penguinyogurt/BME-261/channelAstudy/2026-07-23_134851.png

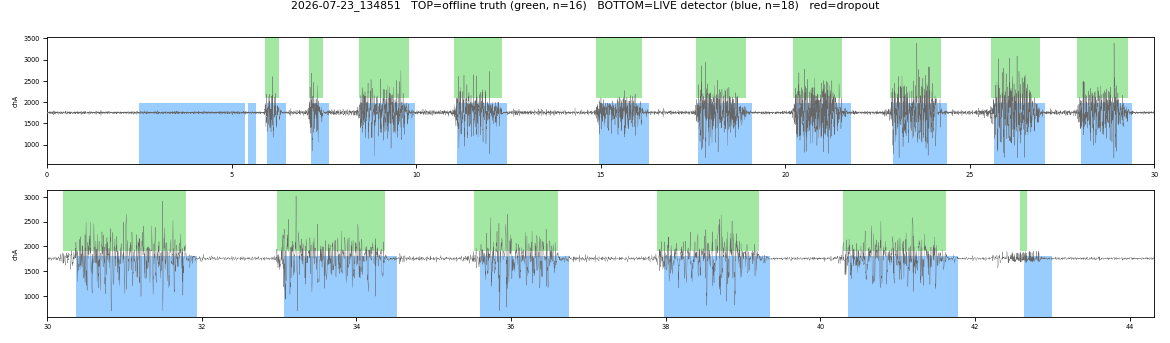
channelAstudy/2026-07-23_134851.png
