penguinyogurt/BME-261/channelAstudy/2026-07-23_182349.png

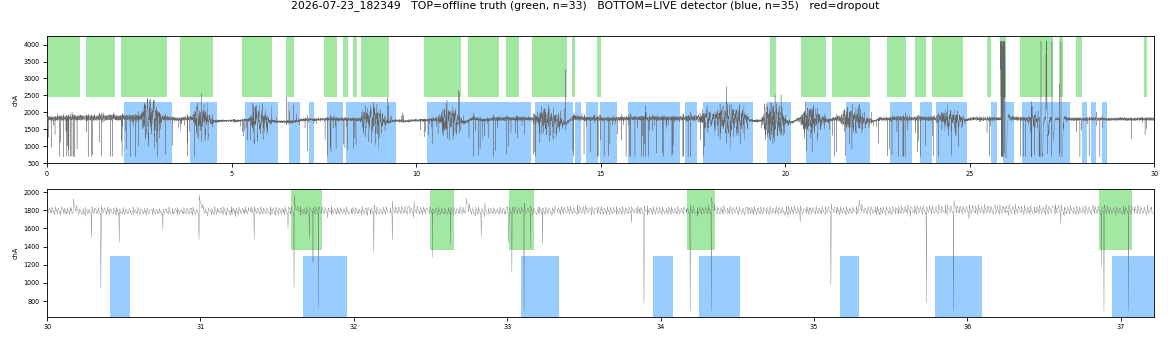
channelAstudy/2026-07-23_182349.png
