penguinyogurt/BME-261/channelAstudy/2026-07-23_190832.png

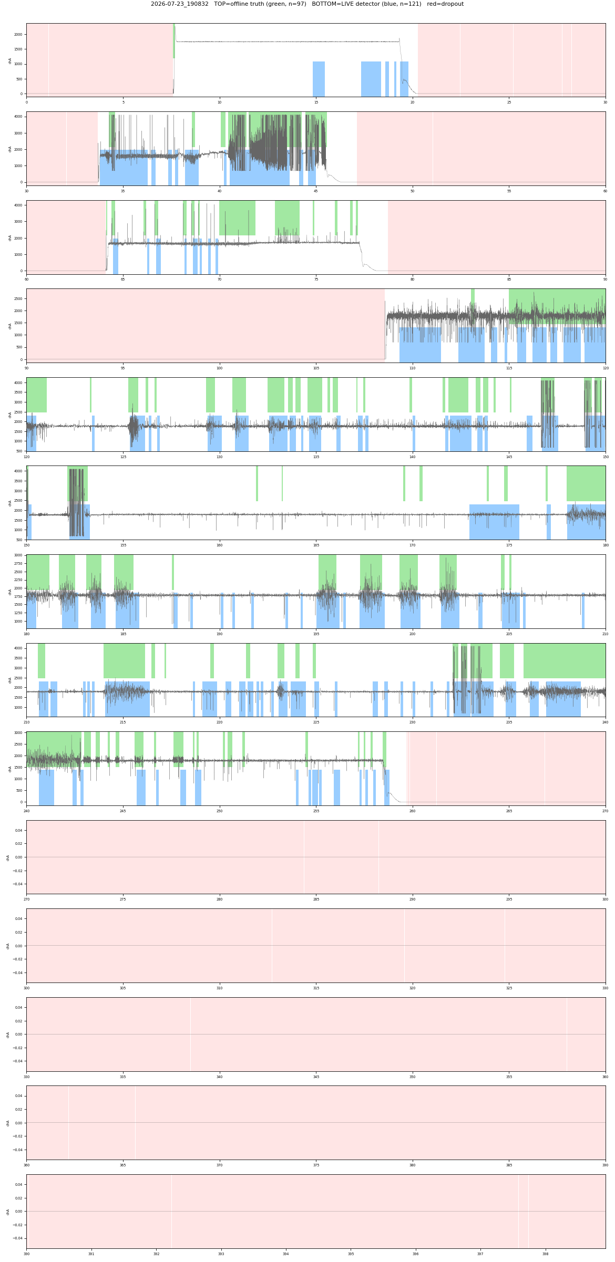
channelAstudy/2026-07-23_190832.png
