penguinyogurt/BME-261/channelAstudy/2026-07-23_195519.png

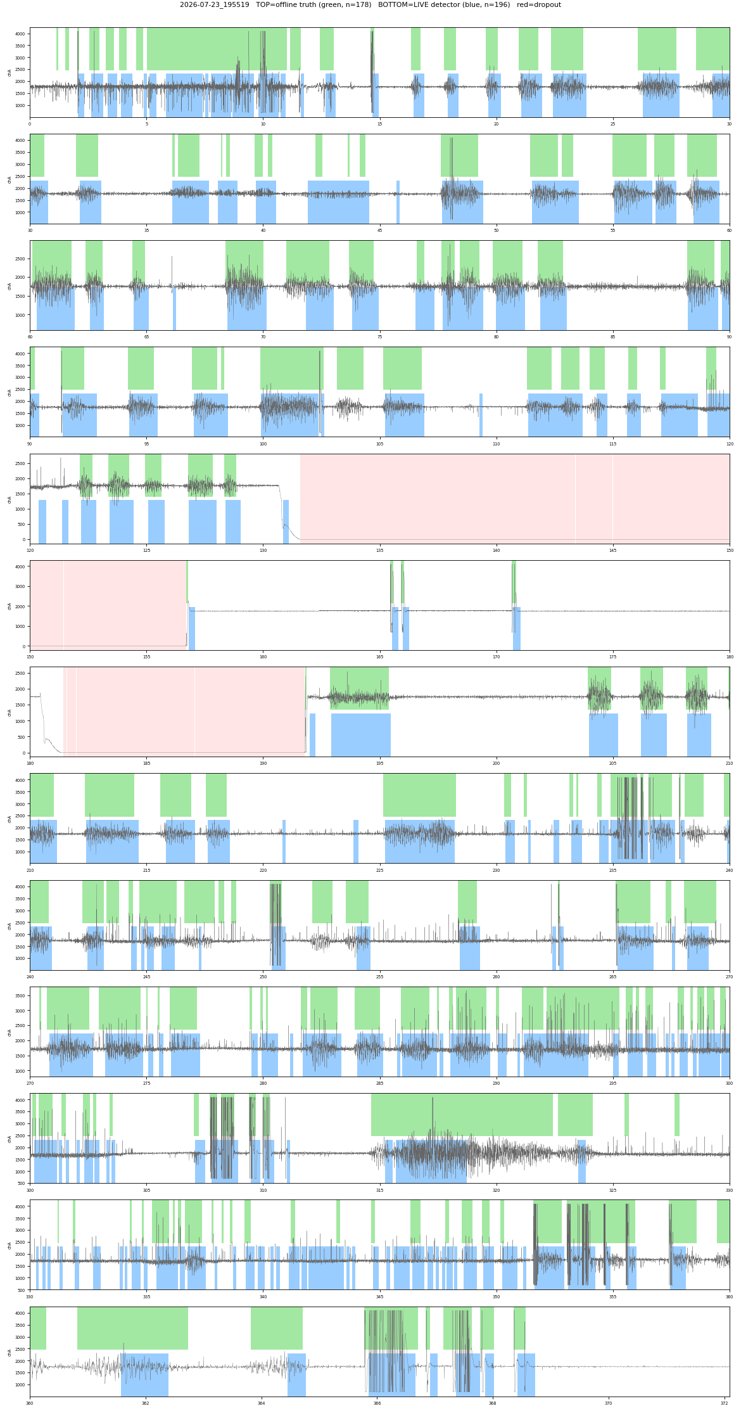
channelAstudy/2026-07-23_195519.png
