penguinyogurt/BME-261/channelAstudy/2026-07-23_202105.png

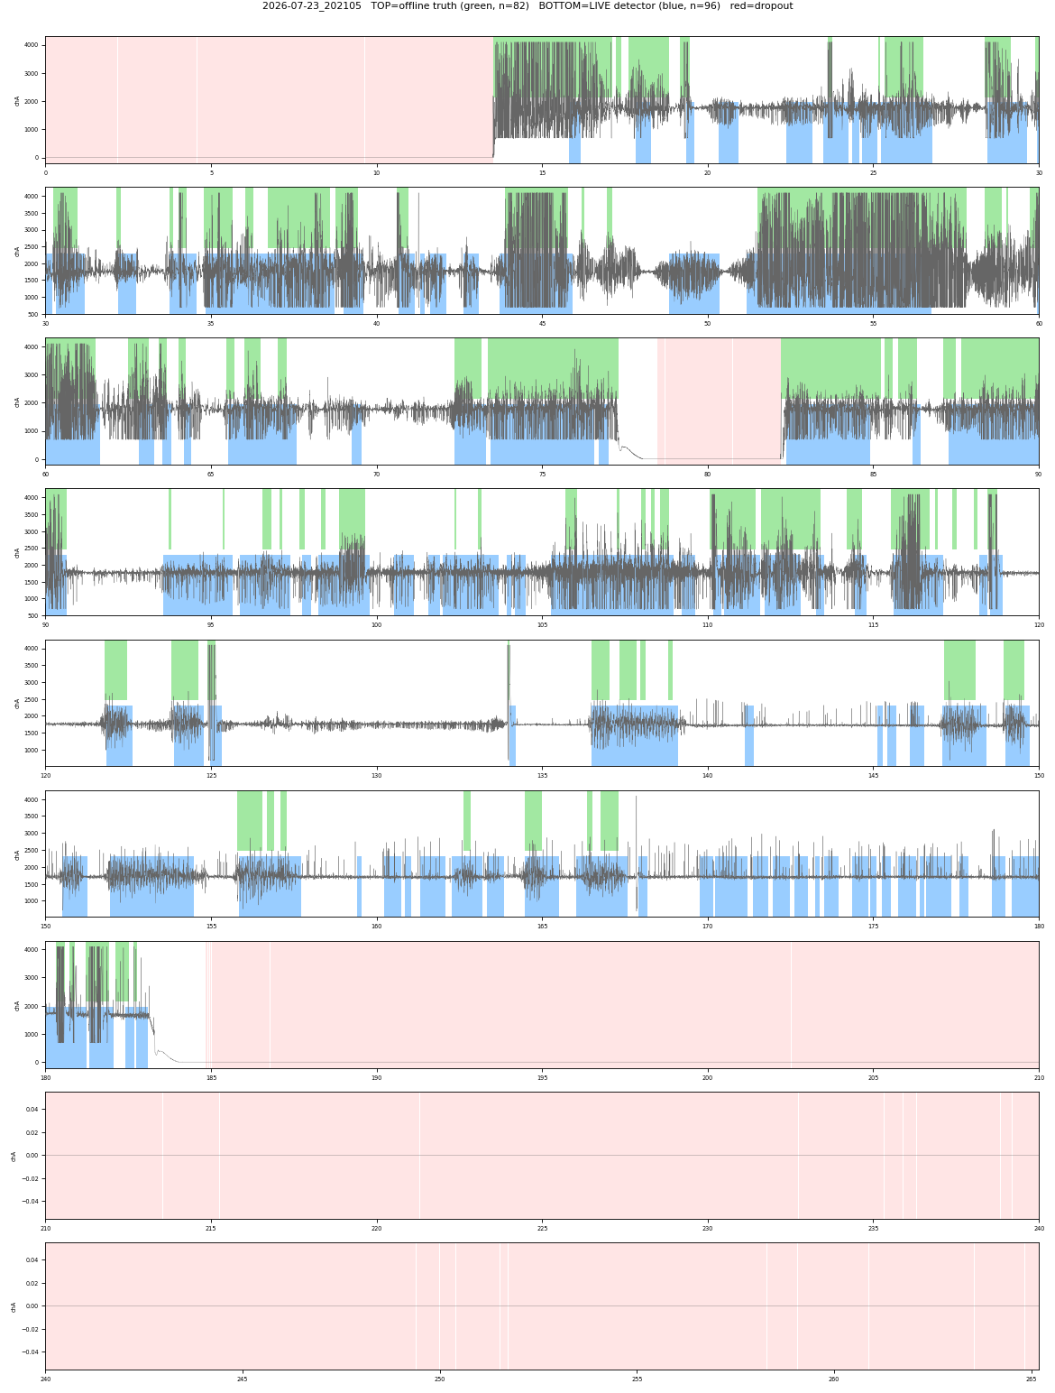
channelAstudy/2026-07-23_202105.png
