penguinyogurt/BME-261/channelAstudy/operating_points.csv

frac_hi | frac_lo | precision | recall | f1 | TP | FN | FP | median_latency_ms
0.06 | 0.03 | 0.6583 | 0.7632 | 0.7068 | 522 | 162 | 271 | 68.0
0.08 | 0.04 | 0.6871 | 0.7865 | 0.7335 | 538 | 146 | 245 | 70.0
0.1 | 0.05 | 0.7064 | 0.788 | 0.745 | 539 | 145 | 224 | 72.0
0.12 | 0.06 | 0.716 | 0.7851 | 0.749 | 537 | 147 | 213 | 72.0
0.14 | 0.07 | 0.7218 | 0.7661 | 0.7433 | 524 | 160 | 202 | 74.0
0.18 | 0.09 | 0.7233 | 0.7222 | 0.7228 | 494 | 190 | 189 | 78.0
0.22 | 0.11 | 0.7282 | 0.6974 | 0.7125 | 477 | 207 | 178 | 84.0
0.28 | 0.14 | 0.7284 | 0.6272 | 0.674 | 429 | 255 | 160 | 90.0
0.35 | 0.175 | 0.7559 | 0.5658 | 0.6472 | 387 | 297 | 125 | 104.0
