penguinyogurt/BME-261/(commit log)

2026-07-22 Add EMG firmware, viewer, servo drive/receiver code, and datasheets
    - BME EMG Arduino Collection.ino: ESP32 EMG sampling firmware with self-test
    - emg-csvs/: serial live-plot viewer plus two captured sample runs
    - hsr2645cr_drive/: working HSR-2645CR continuous-rotation servo demo
    - servo-receiver/: PlatformIO scaffold for the ESP-NOW servo board
    (prints its STA MAC 7C:87:CE:30:FA:88 for sender pairing)
    - ESP32-WROOM-32 and HSR-2645CR datasheets, .gitignore
    [emg_2026-07-21_140307.csv, emg_2026-07-21_140447.csv]
2026-07-23 Reorganize into firmware/tools/data/docs
    - firmware/: all sketches; the loose EMG sketch becomes
    firmware/emg-collector/emg-collector.ino so the folder matches the .ino
    basename (arduino-cli could not build it before)
    - tools/: Python viewer, serial monitor, and offline simulators
    - data/: logged captures + synthetic sets
    - docs/: datasheets
    - scripts now resolve data/ and output/ from the repo root
    - drop duplicate dual_monitor.py (superseded by tools/dual_serial_monitor.py)
    - gitignore generated plots (output/); README documents the layout
    [emg_2026-07-21_140307.csv, emg_2026-07-21_140447.csv, emg_2026-07-23_134728.csv, emg_2026-07-23_134851.csv, emg_synth_close_hold_open.csv, emg_synth_graded_ramp.csv, emg_synth_open_close.csv, emg_synth_rapid_open_close_reps.csv]
2026-07-23 Fix drift-induced perma-close with an adaptive envelope baseline
    The grip would latch closed and never release. Root cause was not the
    calibration trial but the baseline it is measured against: chB's DC was
    measured drifting ~400 counts in 12 s, far wider than T_high, so a one-shot
    tare turned drift into a permanent phantom contraction.
    - envUpdate() now tracks the baseline continuously instead of taring once,
    and handles the two channels as the different signals they are: chB is a
    unipolar envelope (baseline rides the resting floor, clamp at 0), chA is
    bipolar around mid-rail (baseline is the DC bias, rectify).
    - setSource()/calibrate() take the baseline over ~200-500 ms via meanOf()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
    [emg_2026-07-23_171239.csv, emg_2026-07-23_182349.csv, emg_2026-07-23_185723.csv, emg_2026-07-23_185816.csv, emg_2026-07-23_185937.csv]
2026-07-24 Add five more 7-23 capture runs
    Logged with the 4-field firmware, so these carry the env and intent columns
    the earlier runs lack. They cover the cases the older captures did not:
    - 195519, 190832, 202105 have heavy front-end brown-out (chB flat at 0 for
    long stretches)
    - 200828 catches the peak detector's power-on transient, where the firmware
    false-latched a full grip for ~50 s
    - 171239 has a resting floor that steps up ~450 counts mid-recording
    [emg_2026-07-23_193836.csv, emg_2026-07-23_200457.csv, emg_2026-07-23_200828.csv, emg_2026-07-23_202105.csv]
2026-07-24 Add offline replay harness for intent algorithms
    replay_intent.py auto-loads plugins from tools/algos/ and drives each one
    through a shared latching FSM, so competing methods stay apples-to-apples and
    several can be developed in parallel without fighting over one file.
    Causality is enforced structurally rather than by review: a plugin exposes a
    Detector whose update() is fed ONE SAMPLE AT A TIME in arrival order, so it
    cannot see the future even by accident. The three pre-existing algorithms
    (simple/adaptive/fixed) derive thresholds from whole-file percentiles, i.e.
    they peek; they are kept as the incumbent reference but relabelled non-causal.
    play_replay.py replays a logged trial at wall-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
    [play_replay.py, replay_intent.py, sim_simple.py, test_replay.py]
2026-07-24 Add offline answer key and a scorer for intent methods
    There is no recorded ground truth in this project — nobody logged "I squeezed
    now" — so make_answer_key.py builds a strong offline ESTIMATE and labels every
    tick ACTIVE / REST / EXCLUDED. It is deliberately acausal, which is exactly
    what makes it usable as a reference: zero-phase smoothing so onsets are not
    dragged late by filter lag, a CENTERED rest tracker, duration priors in both
    directions, and onset refinement that walks backward to where the raw signal
    actually left rest. No live detector may do any of that.
    Thresholds are scaled to each trial's own resting MAD, not chosen by Otsu:
    the pooled excess-over-rest distribution is o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
    [emg_2026-07-23_134728_key.csv, emg_2026-07-23_134851_key.csv, emg_2026-07-23_171239_key.csv, emg_2026-07-23_182349_key.csv, emg_2026-07-23_185723_key.csv, emg_2026-07-23_185816_key.csv, emg_2026-07-23_185937_key.csv, emg_2026-07-23_190832_key.csv]
2026-07-24 Add the channel-A detection study
    External study of intent detection from chA (raw bandpass) rather than chB:
    DC removal, 20-200 Hz bandpass, TKEO, envelope, hybrid sigma/amplitude
    threshold, Schmitt trigger. Reports leave-one-out F1 0.763 over 684 reference
    bursts, with its own acausal labeler and causality proofs.
    Kept in-tree because it contradicts a premise the rest of this work was built
    on. CLAUDE.md states chA is DEAD and rests near 500 counts; measured across
    every live trial it rests at 1721-1789 counts with std 180-596 and substantial
    high-frequency content. That is working raw EMG, and all seven detectors in
    tools/algos/ ignored it because the project notes said not to bother.
    T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
    [ground_truth_bursts.csv, operating_points.csv]
2026-07-24 Drive intent from the dual-rate ratio, and fix the open travel budget
    DETECTION. Replaces the tared-floor threshold with dualrate: activity is the
    ratio of a fast (40 ms) envelope to a slow one, so it is dimensionless. The
    thresholds become pure numbers and a drifting resting floor moves them with it,
    which removes the tare step entirely — there is nothing to hold still for and
    nothing to calibrate. Chosen by scoring seven causal methods against the
    offline answer key; it was the only one that improved from fit to test, and the
    brute-forced absolute thresholds it beat collapse to 51% quiet on held-out data
    because a fixed number ends up below the resting floor when that floor drifts.
    Veri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
    [emg-collector.ino]
2026-07-24 Add a browser jog control for the servo, over USB serial
    Browser -> local Python server -> USB serial -> the receiver's new "m<intent>"
    command. Serial rather than an on-board web server so the ESP-NOW link is not
    involved at all and cannot be destabilised by sharing a WiFi channel with an AP.
    SAFETY IS HOLD-TO-RUN WITH A FIRMWARE DEADMAN. Each command buys only 400 ms of
    authority and the page re-sends every 120 ms while a button is held, so a
    released button, a closed tab, a crashed browser, an unplugged cable or a killed
    server all stop the motor within 400 ms without anything having to send a stop.
    Silence is the safe state; the explicit stops are belt-and-braces on top. The
    receiver's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
    [main.cpp, motor_debug.py, test_motor_debug.py]
2026-07-24 Fix intent gating found on hardware, and drive close 1.5x faster
    All three changes were flashed to both boards and verified on real hardware.
    SOURCE CHANNEL. The collector defaulted to chA, but dualrate was tuned and
    validated entirely on chB — its thresholds and its REST_LO/REST_HI idle band
    are chB's. It was running the right algorithm on the wrong channel.
    READY LATCH. `ready` was computed once, at boot, from the resting chB level:
    ready = (meanB > DEAD_ABS) || (srcPin == PIN_RAW);
    and intentTick gates on `alive = ready && raw > DEAD_ABS`. A board powered up
    before its analog front end therefore latched ready=false and produced ZERO
    intent forever — the viewer's intent trace s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
    [emg-collector.ino, main.cpp]
2026-07-24 Track grip travel in real units, from a measured full-travel time
    Flashed to both boards and confirmed working on the mechanism.
    THE UNITS. gripDrive/gripEst now count SECONDS OF FULL-SPEED-EQUIVALENT DRIVE
    instead of a normalised 0..1 fraction. The old integrator divided by a
    FULL_TRAVEL_S constant, but that is a constant divisor which cancels out of the
    unwind completely — it never affected the control path, it only scaled the
    grip% readout while making the units hard to reason about. Verified
    behaviour-identical over four close/open scenarios before changing anything
    else. Driving at half speed for 2 s now plainly equals full speed for 1 s, and
    an open simply gives back what a close pu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
2026-07-24 Add the demo folder, refreshed from canonical, plus a sync script
    demo/ collects everything needed to run the grip end to end — both firmwares,
    the viewer, the jog page, the link test — so a demo does not mean hunting
    through the repo. The README walks the whole thing from wiring to a full run,
    with a troubleshooting table.
    THE COPIES WERE STALE, which is why sync_demo.py exists rather than a note
    asking people to be careful. demo/ was carrying the PRE-DUALRATE collector
    (814 lines behind) and the pre-measurement receiver, so anyone following the
    README would have flashed the firmware that creeps shut — strictly worse than
    having no copy at all. The README already warned "don't let th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
